schenkmi/Mini8085/KiCad/Mini8085.kicad_pcb

## KiCad design KiCad/Mini8085.kicad_pcb (2019-10-15)

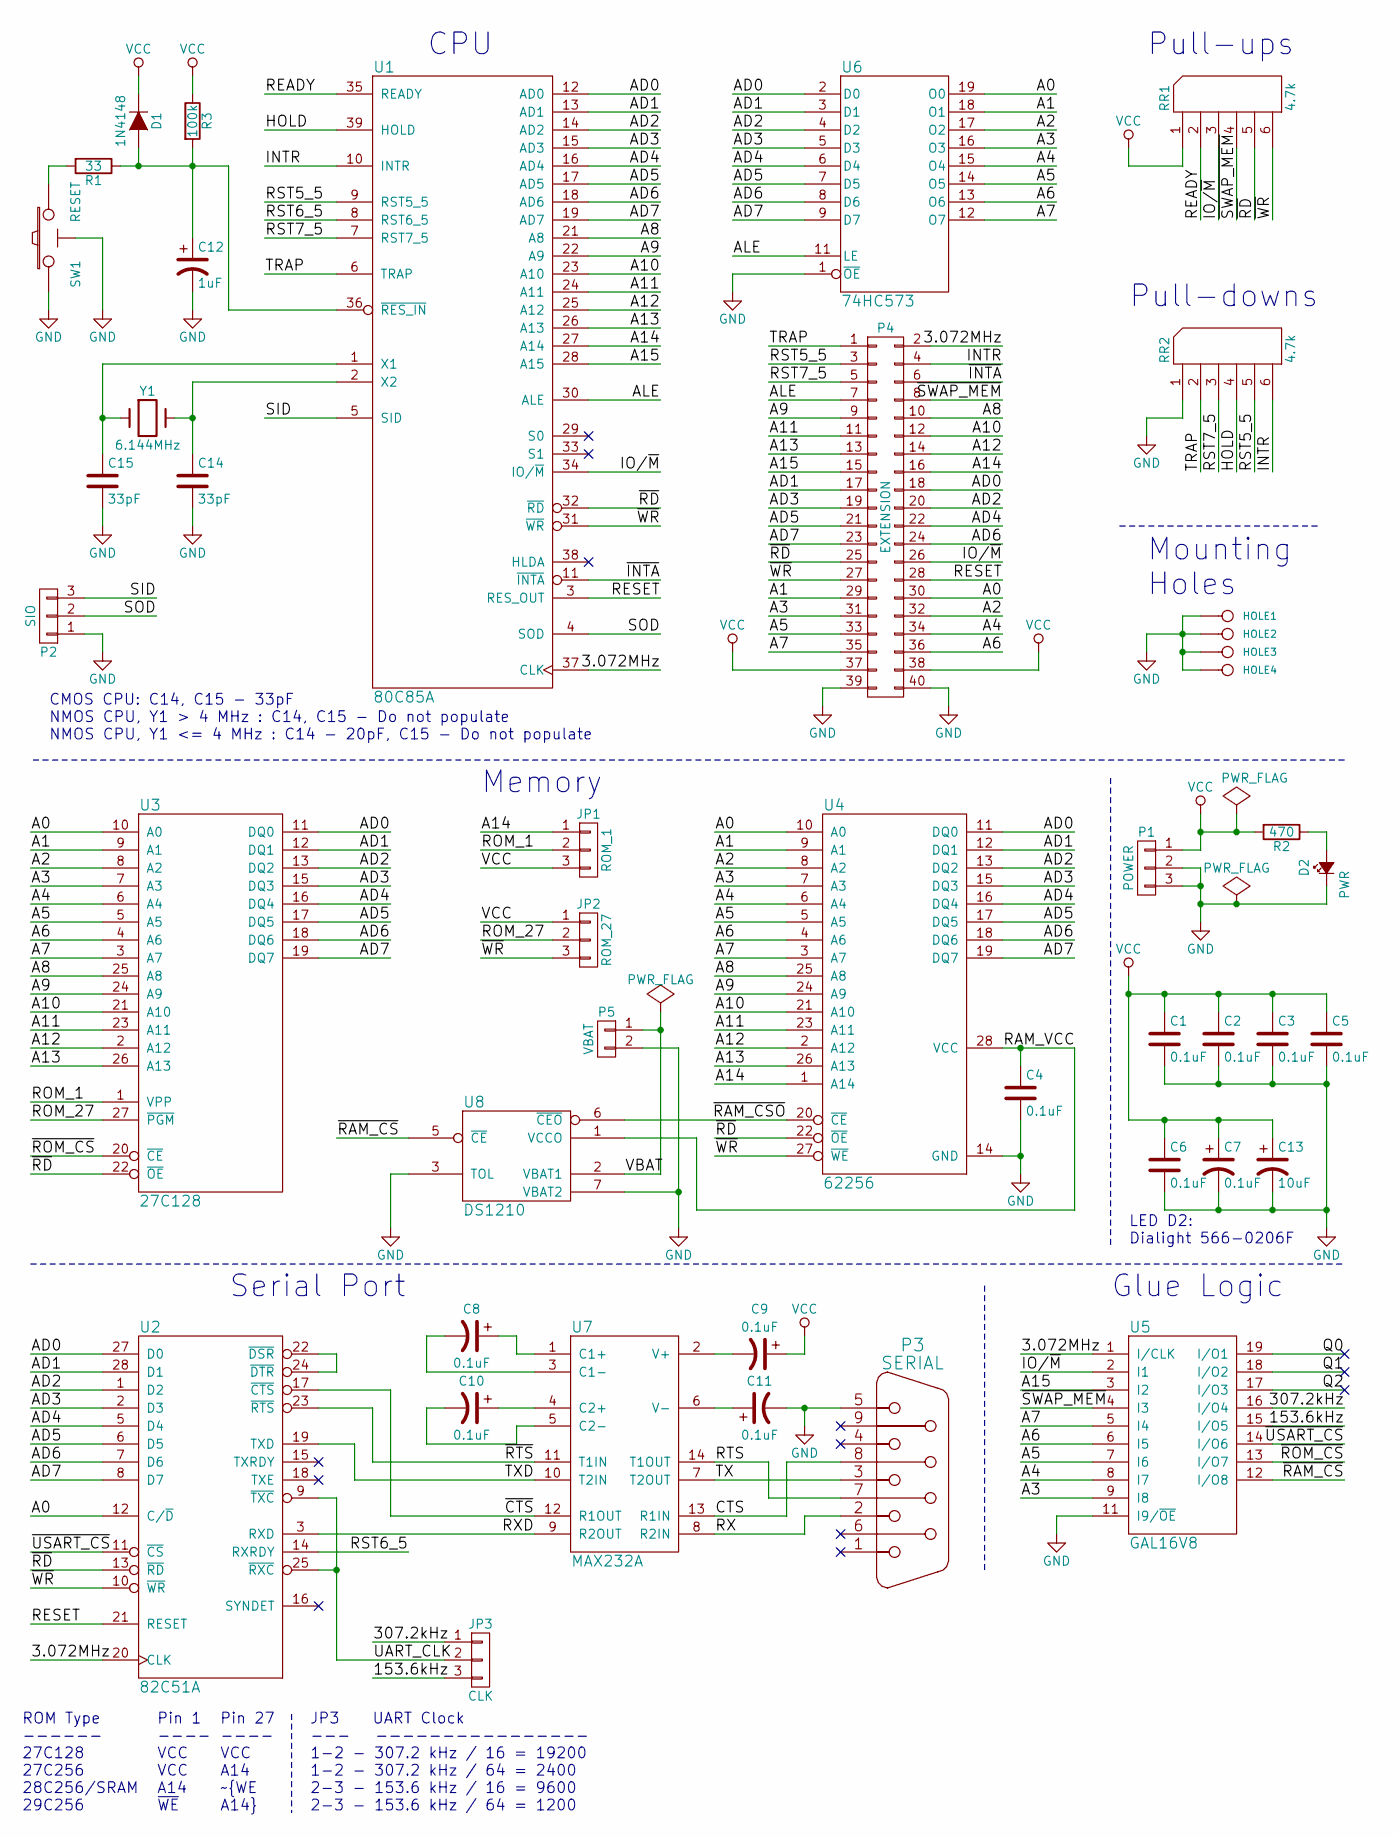
[picture p1: schematic Mini8085.sch, Minimal 8085A Single Board Computer]

Parts:
C1, C2, C3, C4, C5, C6: 0.1uF; Cap_Cer_508
C7, C8, C9, C10, C11: 0.1uF; Cap_Pol_508_3
C12: 1uF; Cap_Pol_508_3
C13: 10uF; Cap_Pol_508_3
C14, C15: 33pF; Cap_Cer_508
D1: 1N4148; Diode_762
D2: PWR; LED_Dialight_566-0206F
HOLE1, HOLE2, HOLE3, HOLE4: CONN_1; Hole_3mm
JP1: ROM_1; Conn_Pin_Header_3x1_2.54mm
JP2: ROM_27; Conn_Pin_Header_3x1_2.54mm
JP3: CLK; Conn_Pin_Header_3x1_2.54mm
P1: POWER; Conn_Power_Jack_Circular_Pads
P2: SIO; Conn_Pin_Header_3x1_2.54mm
P3: SERIAL; Conn_Dsub_DE9M
P4: EXTENSION; Conn_Pin_Header_20x2_2.54mm
P5: VBAT; Conn_Friction_Lock_2P_2.54mm
R1: 33; Res_762
R2: 470; Res_762
R3: 100k; Res_762
RR1, RR2: 4.7k; Conn_SIL6
SW1: RESET; Switch_Tactile_6mm_Right
U1: 80C85A; IC_DIP40_600
U2: 82C51A; IC_DIP28_600
U3: 27C128; IC_DIP28_600
U4: 62256; IC_DIP28_600
U5: GAL16V8; IC_DIP20_300
U6: 74HC573; IC_DIP20_300
U7: MAX232A; IC_DIP16_300
U8: DS1210; IC_DIP8_300
Y1: 6.144MHz; Crystal_HC-49U_Vert

Connections:
/3.072MHz: P4.2, U1.37 (CLK), U2.20 (CLK), U5.1 (I/CLK)
/153.6kHz: JP3.3, U5.15 (I/O5)
/307.2kHz: JP3.1, U5.16 (I/O4)
/A0: P4.30, U2.12 (C/~D), U3.10 (A0), U4.10 (A0), U6.19 (O0)
/A1: P4.29, U3.9 (A1), U4.9 (A1), U6.18 (O1)
/A2: P4.32, U3.8 (A2), U4.8 (A2), U6.17 (O2)
/A3: P4.31, U3.7 (A3), U4.7 (A3), U5.9 (I8), U6.16 (O3)
/A4: P4.34, U3.6 (A4), U4.6 (A4), U5.8 (I7), U6.15 (O4)
/A5: P4.33, U3.5 (A5), U4.5 (A5), U5.7 (I6), U6.14 (O5)
/A6: P4.36, U3.4 (A6), U4.4 (A6), U5.6 (I5), U6.13 (O6)
/A7: P4.35, U3.3 (A7), U4.3 (A7), U5.5 (I4), U6.12 (O7)
/A8: P4.10, U1.21 (A8), U3.25 (A8), U4.25 (A8)
/A9: P4.9, U1.22 (A9), U3.24 (A9), U4.24 (A9)
/A10: P4.12, U1.23 (A10), U3.21 (A10), U4.21 (A10)
/A11: P4.11, U1.24 (A11), U3.23 (A11), U4.23 (A11)
/A12: P4.14, U1.25 (A12), U3.2 (A12), U4.2 (A12)
/A13: P4.13, U1.26 (A13), U3.26 (A13), U4.26 (A13)
/A14: JP1.1, P4.16, U1.27 (A14), U4.1 (A14)
/A15: P4.15, U1.28 (A15), U5.3 (I2)
/AD0: P4.18, U1.12 (AD0), U2.27 (D0), U3.11 (DQ0), U4.11 (DQ0), U6.2 (D0)
/AD1: P4.17, U1.13 (AD1), U2.28 (D1), U3.12 (DQ1), U4.12 (DQ1), U6.3 (D1)
/AD2: P4.20, U1.14 (AD2), U2.1 (D2), U3.13 (DQ2), U4.13 (DQ2), U6.4 (D2)
/AD3: P4.19, U1.15 (AD3), U2.2 (D3), U3.15 (DQ3), U4.15 (DQ3), U6.5 (D3)
/AD4: P4.22, U1.16 (AD4), U2.5 (D4), U3.16 (DQ4), U4.16 (DQ4), U6.6 (D4)
/AD5: P4.21, U1.17 (AD5), U2.6 (D5), U3.17 (DQ5), U4.17 (DQ5), U6.7 (D5)
/AD6: P4.24, U1.18 (AD6), U2.7 (D6), U3.18 (DQ6), U4.18 (DQ6), U6.8 (D6)
/AD7: P4.23, U1.19 (AD7), U2.8 (D7), U3.19 (DQ7), U4.19 (DQ7), U6.9 (D7)
/ALE: P4.7, U1.30 (ALE), U6.11 (LE)
/CTS: P3.8, U7.13 (R1IN)
/HOLD: RR2.4, U1.39 (HOLD)
/INTR: P4.4, RR2.6, U1.10 (INTR)
/IO/~M: P4.26, RR1.3, U1.34 (IO/~M), U5.2 (I1)
/Q0: U5.19 (I/O1)
/Q1: U5.18 (I/O2)
/Q2: U5.17 (I/O3)
/RAM_VCC: C4.1, U4.28 (VCC), U8.1 (VCCO)
/READY: RR1.2, U1.35 (READY)
/RESET: P4.28, U1.3 (RES_OUT), U2.21 (RESET)
/ROM_1: JP1.2, U3.1 (VPP)
/ROM_27: JP2.2, U3.27 (~PGM)
/RST5_5: P4.3, RR2.5, U1.9 (RST5_5)
/RST6_5: U1.8 (RST6_5), U2.14 (RXRDY)
/RST7_5: P4.5, RR2.3, U1.7 (RST7_5)
/RTS: P3.7, U7.14 (T1OUT)
/RX: P3.2, U7.8 (R2IN)
/RXD: U2.3 (RXD), U7.9 (R2OUT)
/SID: P2.3, U1.5 (SID)
/SOD: P2.2, U1.4 (SOD)
/TRAP: P4.1, RR2.2, U1.6 (TRAP)
/TX: P3.3, U7.7 (T2OUT)
/TXD: U2.19 (TXD), U7.10 (T2IN)
/UART_CLK: JP3.2, U2.9 (~TXC), U2.25 (~RXC)
/VBAT: P5.1, U8.2 (VBAT1)
/~CTS: U2.17 (~CTS), U7.12 (R1OUT)
/~INTA: P4.6, U1.11 (~INTA)
/~RAM_CS: U5.12 (I/O8), U8.5 (~CE)
/~RAM_CSO: U4.20 (~CE), U8.6 (~CEO)
/~RD: P4.25, RR1.5, U1.32 (~RD), U2.13 (~RD), U3.22 (~OE), U4.22 (~OE)
/~ROM_CS: U3.20 (~CE), U5.13 (I/O7)
/~RTS: U2.23 (~RTS), U7.11 (T1IN)
/~SWAP_MEM: P4.8, RR1.4, U5.4 (I3)
/~USART_CS: U2.11 (~CS), U5.14 (I/O6)
/~WR: JP2.3, P4.27, RR1.6, U1.31 (~WR), U2.10 (~WR), U4.27 (~WE)
GND: C1.2, C2.2, C3.2, C4.2, C5.2, C6.2, C7.2, C11.2, C12.2, C13.2, C14.2, C15.2, D2.1 (K), HOLE1.1, HOLE2.1, HOLE3.1, HOLE4.1, P1.2, P1.3, P2.1, P3.5, P3.GND, P4.39, P4.40, P5.2, RR2.1 (COM), SW1.1, SW1.GND, U1.20 (GND), U2.4 (GND), U3.14 (GND), U4.14 (GND), U5.10 (GND), U5.11 (I9/~OE), U6.1 (~OE), U6.10 (GND), U7.15 (GND), U8.3 (TOL), U8.4 (GND), U8.7 (VBAT2)
unnamed: C8.1, U7.1 (C1+)
unnamed: C8.2, U7.3 (C1-)
unnamed: C9.2, U7.2 (V+)
unnamed: C10.1, U7.4 (C2+)
unnamed: C10.2, U7.5 (C2-)
unnamed: C11.1, U7.6 (V-)
unnamed: C12.1, D1.2 (A), R1.1, R3.2, U1.36 (~RES_IN)
unnamed: C14.1, U1.2 (X2), Y1.2
unnamed: C15.1, U1.1 (X1), Y1.1
unnamed: D2.2 (A), R2.1
unnamed: R1.2, SW1.2
unnamed: U2.22 (~DSR), U2.24 (~DTR)
VCC: C1.1, C2.1, C3.1, C5.1, C6.1, C7.1, C9.1, C13.1, D1.1 (K), JP1.3, JP2.1, P1.1, P4.37, P4.38, R2.2, R3.1, RR1.1 (COM), U1.40 (VCC), U2.26 (VCC), U3.28 (VCC), U5.20 (VCC), U6.20 (VCC), U7.16 (VCC), U8.8 (VCC)

Notes on the sheet:
ROM Type ------ 27C128 27C256 28C256/SRAM 29C256
CMOS CPU: C14, C15 - 33pF NMOS CPU, Y1 > 4 MHz : C14, C15 - Do not populate NMOS CPU, Y1 <= 4 MHz : C14 - 20pF, C15 - Do not populate
Memory
Serial Port
CPU
Pull-downs
Mounting Holes
LED D2: Dialight 566-0206F
Glue Logic
Pull-ups
JP3 UART Clock --- ---------------- 1-2 - 307.2 kHz / 16 = 19200 1-2 - 307.2 kHz / 64 = 2400 2-3 - 153.6 kHz / 16 = 9600 2-3 - 153.6 kHz / 64 = 1200
Pin 1 ---- VCC VCC A14 ~WE
Pin 27 ---- VCC A14 ~WE A14

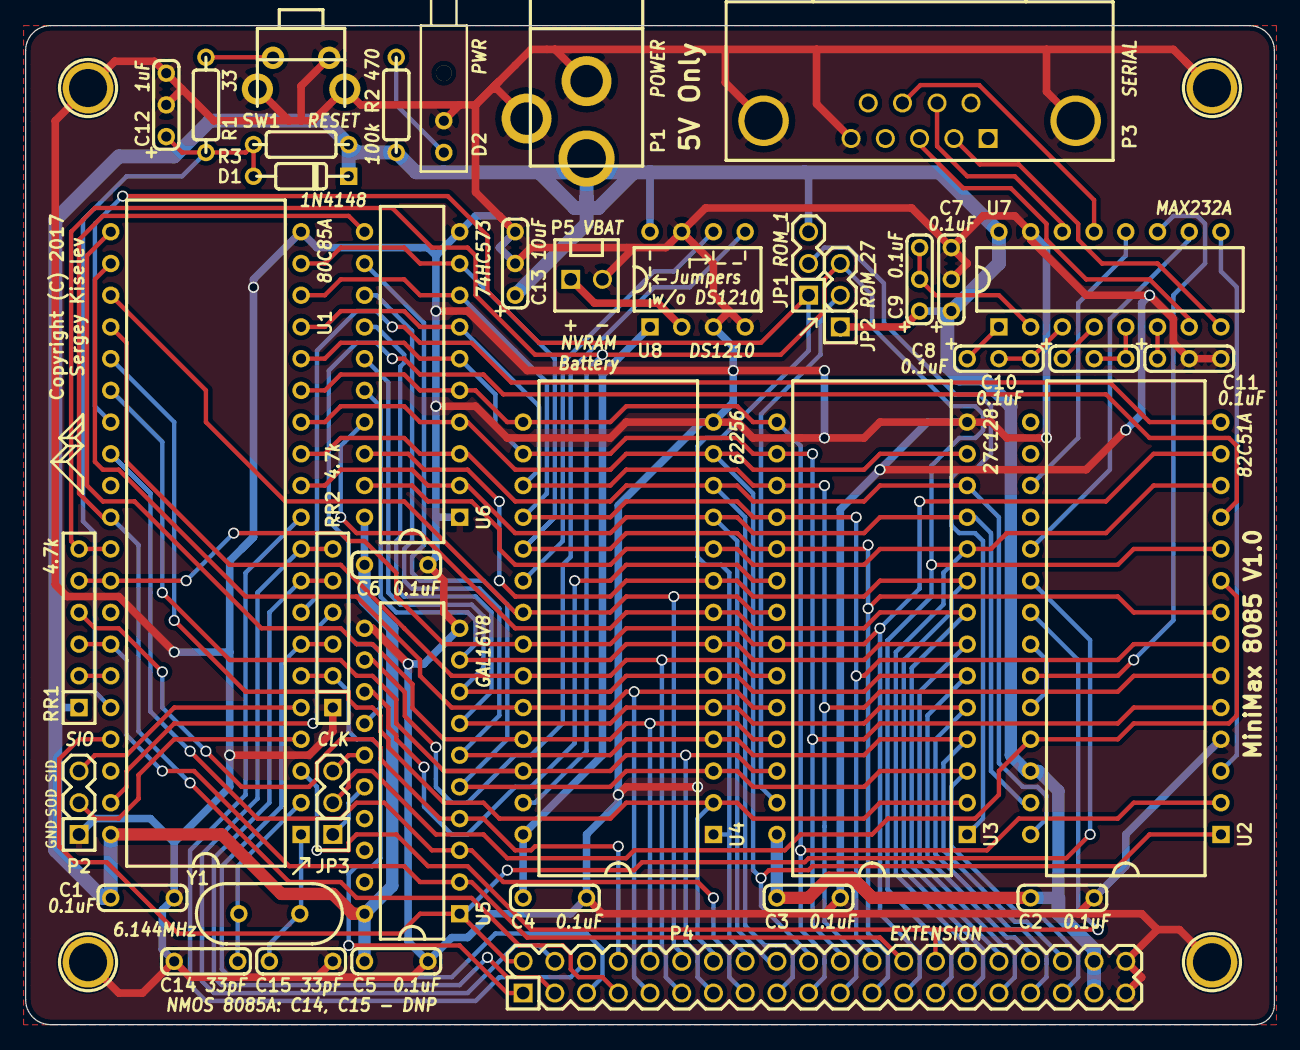
[picture p2: board Mini8085.kicad_pcb from above]

Board: 2 copper layers, 100.0 x 80.0 mm, 44 parts (0 on the bottom side), 74 nets.
