schenkmi/Mini8085/(notices)

Notices in the files:
KiCad/Mini8085.kicad_pcb:
Copyright (C) 2017
